akif999/e220_feather-m4_dbg_borad/kicad/feather-m4_e220_dbg_board/feather-m4_e220_dbg_board.kicad_sch

## KiCad design kicad/feather-m4_e220_dbg_board/feather-m4_e220_dbg_board.kicad_sch (2023-02-27)

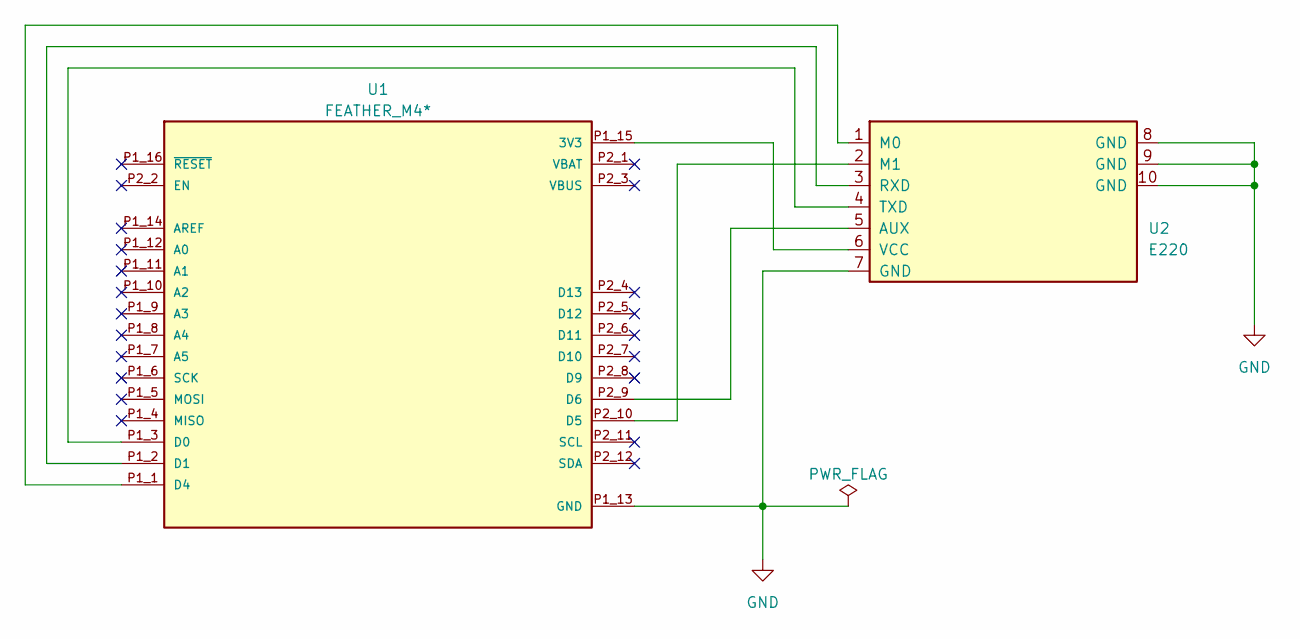
[picture p3: schematic feather-m4_e220_dbg_board.kicad_sch]

Parts:
U1: FEATHER_M4*; MODULE_FEATHER_M4_EXPRESS
U2: E220; E220-900T22S(JP)

Connections:
GND: U1.P1_13 (GND), U2.7 (GND), U2.8 (GND), U2.9 (GND), U2.10 (GND)
unnamed: U1.P1_1 (D4), U2.1 (M0)
unnamed: U1.P1_2 (D1), U2.3 (RXD)
unnamed: U1.P1_3 (D0), U2.4 (TXD)
unnamed: U1.P1_15 (3V3), U2.6 (VCC)
unnamed: U1.P2_9 (D6), U2.5 (AUX)
unnamed: U1.P2_10 (D5), U2.2 (M1)
