akif999/e220_feather-m4_dbg_borad/(commit log)

2023-02-22 Associating symbols and footprints
2023-02-23 add circuit diagram
    [feather-m4_e220_dbg_board.kicad_sch]
2023-02-23 make pcb
    [feather-m4_e220_dbg_board.kicad_pcb]
2023-02-27 Changed to place through holes for remaining E220 (as Pin8-9)
    [feather-m4_e220_dbg_board.kicad_pcb, feather-m4_e220_dbg_board.kicad_sch]
2023-02-27 add pin numbers of E220 to PCB
    [feather-m4_e220_dbg_board.kicad_pcb]
2023-03-09 add gerber files
    [feather-m4_e220_dbg_board-B_Cu.gbr, feather-m4_e220_dbg_board-B_Mask.gbr, feather-m4_e220_dbg_board-B_Paste.gbr, feather-m4_e220_dbg_board-B_Silkscreen.gbr, feather-m4_e220_dbg_board-Edge_Cuts.gbr, feather-m4_e220_dbg_board-F_Cu.gbr, feather-m4_e220_dbg_board-F_Mask.gbr, feather-m4_e220_dbg_board-F_Paste.gbr]
